yenescaliskan/DC_Motor_Drive/Simulation Report.docx

Middle East Technical University

Electrical & Electronics Engineering Department

EE463 – Static Power Conversion I

Hardware Project

Complete Simulation Report

Yasin Enes Çalışkan 2304319

Başak Koca 2232304

Mehmet Hakan Yel 2530699

# Introduction

For the motor drive system in the power electronics field, converters and rectifiers are essential. This project involves designing an AC/DC converter. The potential topologies discussed in this simulation report. The topology selection is made with respect to advantages and disadvantages of the design. The computation and simulations are provided for the chosen topology. There are both ideal and non-ideal instances in the simulations. The necessary components are selected utilizing the findings of studies following simulation and calculation analysis. Thermal analysis of the system is made.

# Problem Definition

Designing a controlled rectifier to drive a DC motor is a requirement for this project. The variable AC source is employed as the input. A kettle is wired to the DC motor and used to boil water.

Input and output constraints:

- Input: Three phase or single-phase AC
- Output: DC Output, Vdcmax <180 V

Motor specifications:

- Armature Winding: 0.8 Ω, 12.5 mH
- Shunt Winding: 210 Ω, 23 H
- Interpoles Winding: 0.27 Ω, 12 mH

# Possible Topologies for Solution

## 1) Single Phase Thyristor Rectifier

The Single-Phase Thyristor Rectifier design provides regulated operation. There are four thyristors in the topology. By altering the thyristors' firing angle, the rectifier's average output voltage can be changed. Therefore, with this architecture, we can convert AC to variable DC.

Applying a pulse signal to the thyristors' gate terminals regulates how they fire. The zero crossings of the input ac waveform should be recognized to synchronize the thyristors' firing timings. There must be a 180-degree phase difference between the firing angles. There is significant output voltage ripple. A capacitor with a high capacitance can be added to the system to decrease the high voltage ripple at the output.

There are two modes of single-phase thyristor rectifier. Average output voltage and current are positive when in rectification mode. Power flows through the rectifier in this mode from the input side to the output side. On the other hand, average output voltage turns negative while the output current remains positive in the inverter mode of operation. The power flows from output side to input side. Thus, the rectifier feeds power back into the grid. Average output voltage is seen in equation 1.

Vav=(2√2)/π Vph cosα (1)

Advantages

- Due to the fewer thyristors needed, it is affordable and small.
- By coupling two Single Phase Thyristor Rectifier circuits, it may be operated in four quadrants. If there is an active source on the rectifier's output side when it is in inverter mode, it can send power back to the grid. A positive current can flow while the output voltage remains positive.

Disadvantages

- The output has a high voltage ripple.
- It causes large harmonics in current. It can be reduced by adding inductor to the input, however that causes to increase in commutation time.
- It has low power factor.
- It is challenging to organize firing angles synchronously and extra circuits and sources are required to drive thyristors.
- A lower average output voltage than a three-phase thyristor rectifier.

Figure 1. Single Phase Thyristor Rectifier with RL Load

## 2) Three Phase Thyristor Rectifier

Figure 2. Three phase thyristor rectifier schematics.

Six thyristors are employed in the three phase thyristor rectifier. Thyristors are activated using gate signal generators to regulate output voltage. Theoretical output voltage calculation is as follows,

V_(avg) =(3√2 V_(ll))/πcosα=(3√6 V_(ph))/πcosα (2)

Advantages

- Without using an extra converter, the output voltage can be managed with a three phase thyristor rectifier.
- Output voltage ripple of this topology is lower than the single-phase thyristor rectifier topology.
- THD of this topology is lower. Since, the third harmonic of the input current is not observed.
- Back-to-back three phase thyristor rectifiers can be used to achieve four quadrant operation.

Disadvantages

- Thyristors are more expensive than regular diodes as component, and six thyristors make up this topology. This topology is therefore more expensive than other alternatives.
- Three phase thyristor rectifier topology requires the usage of six separate gate signals. In order to do this, gate drivers and additional components are needed. It raises the price and makes the structure more difficult.
- It is challenging to synchronize gate drivers. Since it should be taken into account, the zero-crossing issue.

## 3) Three Phase Diode Rectifier and Buck Converter

There are two sections of this topology. Three phase ac grid voltage is rectified in the first section to low ripple dc voltage. In the second section, we use a buck converter to adjust the output voltage using the switch's duty cycle.

Figure 3. Three phase diode rectifier schematic.

There is no control of average output voltage for three phase diode rectifier. Calculation of the output voltage is as follows,

V_(avg) =(3√2 V_(ll))/π=(3√6 V_(ph))/π (3)

In order to control the output voltage, a buck converter must be used after the rectifier circuit.

Figure 4. Buck converter schematic.

The input dc voltage is step-down to the desired level by the buck converter. A MOSFET that is driven by a gate signal is used to regulate output voltage. Output voltage of a buck converter simply calculated as,

V_(out) =V_(in) *D (4)

As we connect the rectifier and the buck converter, the output voltage becomes,

V_(avg) =(3√2 V_(ll))/π*D=(3√6 V_(ph))/π*D (5)

Advantages

- This topology has low voltage ripple in output.
- Only one gate signal is needed for this topology, and it will be supplied to operate the buck converter. In comparison to other topologies, this system is hence simpler. Additionally, syncing the signals is not needed in this topology.
- The cost of this system is lower than that of thyristor rectifiers.

Disadvantages

- Four quadrant operation is not supported by this topology. There is no method to obtain four quadrants because a diode rectifier can only operate in one quadrant.
- As a result of using an external diode in the buck converter, the predicted efficiency is lower than topologies with thyristors.

# Topology Selection and Reasoning

We gave information about 3 different alternative topologies that can be used within the scope of the project. We also listed the advantages and disadvantages of each topology. When we compared the advantages of each topology, we decided that three phase diode rectifiers with buck converter would be the most suitable topology for us.

The most effective factor in the selection of three phase diode rectifier topology with buck converter was simplicity. In other rectifier topologies using thyristor, it would be necessary to generate multiple gate signals and perform zero crossing detection to control the system. However, in a topology with a diode rectifier, only the gate signal will be needed for the buck converter that we will add to the system. In addition, its cheapness and low output voltage were also effective in our decision.

# Simulations of Selected Topology

In this part, the simulation of the topology we have chosen are made part by part.

## a) Three Phase Diode Rectifier Simulation

Within the scope of the project, we were asked to drive the motor with a maximum of 180V DC. Therefore, the output voltage that we will see at the output of our entire system at the maximum duty cycle value that we will determine for the buck converter should be 180Vrms DC. When we consider the output that the buck converter will provide, we know that the output voltage of buck converters varies in direct proportion according to the duty cycle percentage of the switch used in the converter. However, since high duty cycle values cannot be achieved in practice, we have determined the maximum duty cycle value of the gate signal that we will use for the switching process as 80%. For us to see 180Vrms in the buck converter output with 80% duty cycle, our input phase voltage should be calculated as follows,

V_(out) =(3√6 V_(ph))/π*D where V_(out) =180V and D=0.8 (6)

V_(ph) =96.2V_(rms)

Since the ideal case will be considered in our simulation, the value of 96.2Vrms is used as the input pahse voltage. However, due to the voltage drop due to commutation and other nonidealities, the amount of input voltage will need to increase a little more.

The circuit schematic used for the simulation of the three-phase diode rectifier is as in figure 5.

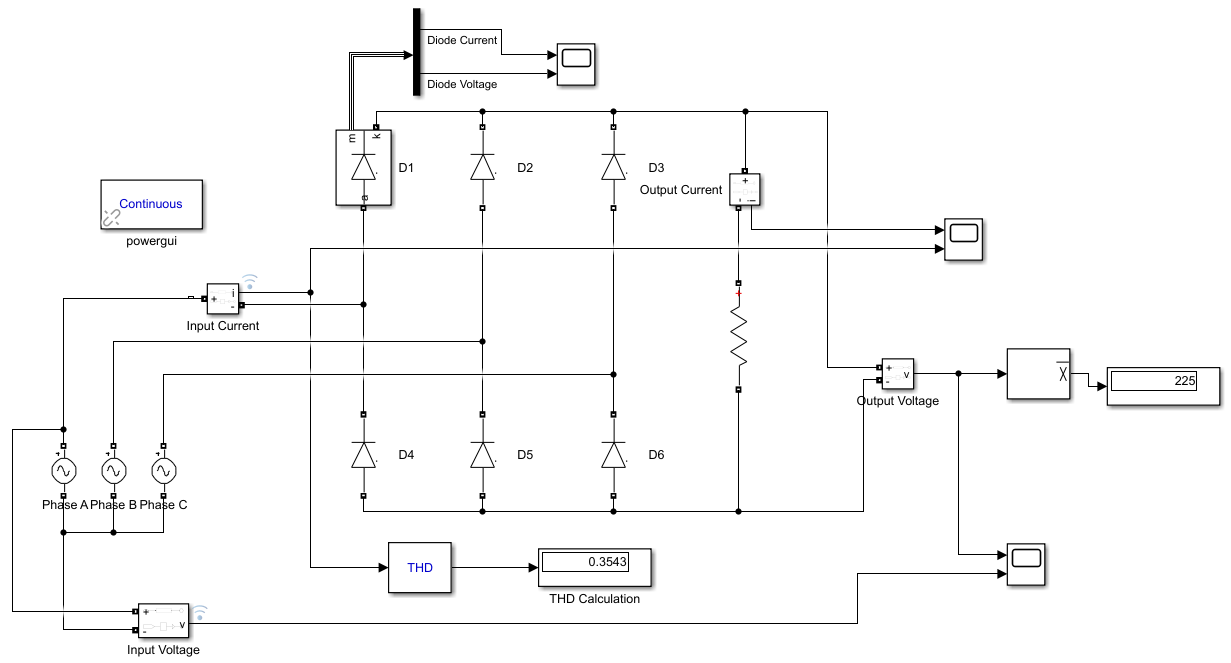
[picture p2: figure]

Figure 5. Circuit schematic for simulation of three phase diode rectifier.

Simulation results of input and output voltage waveform are included in figure 6.

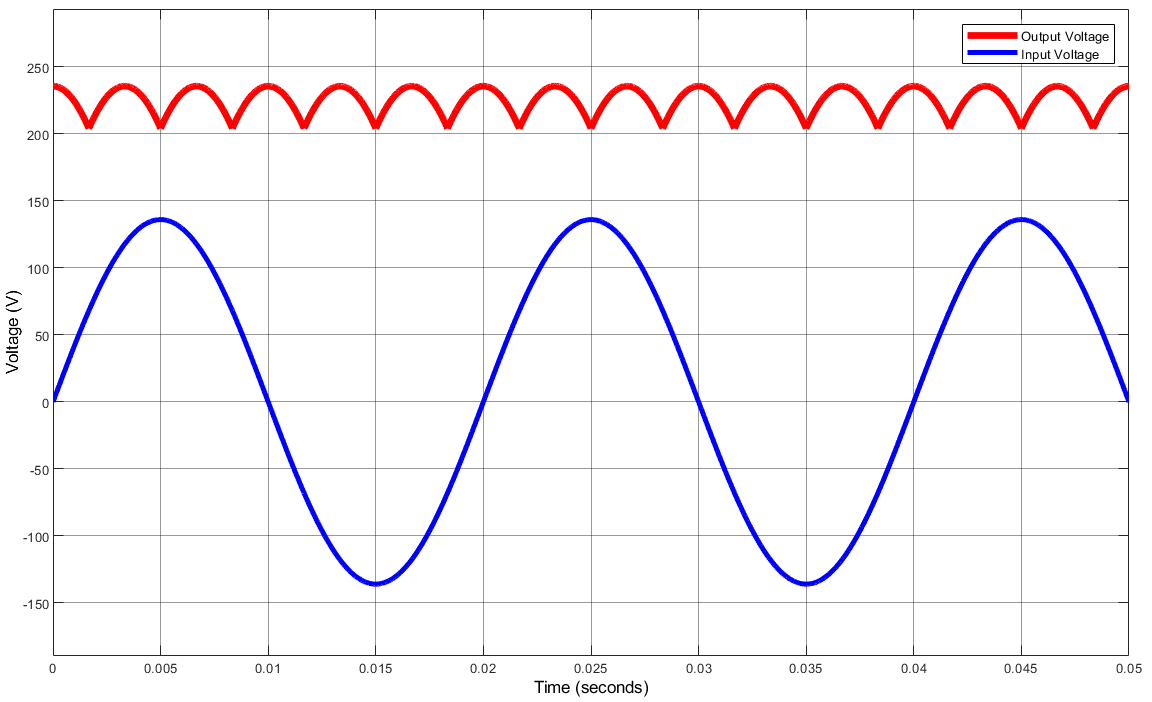
[picture p3: figure]

Figure 6. Input and output voltage waveforms of three phase diode rectifier.

The simulation results of the input and output current waveform are given in figure 7.

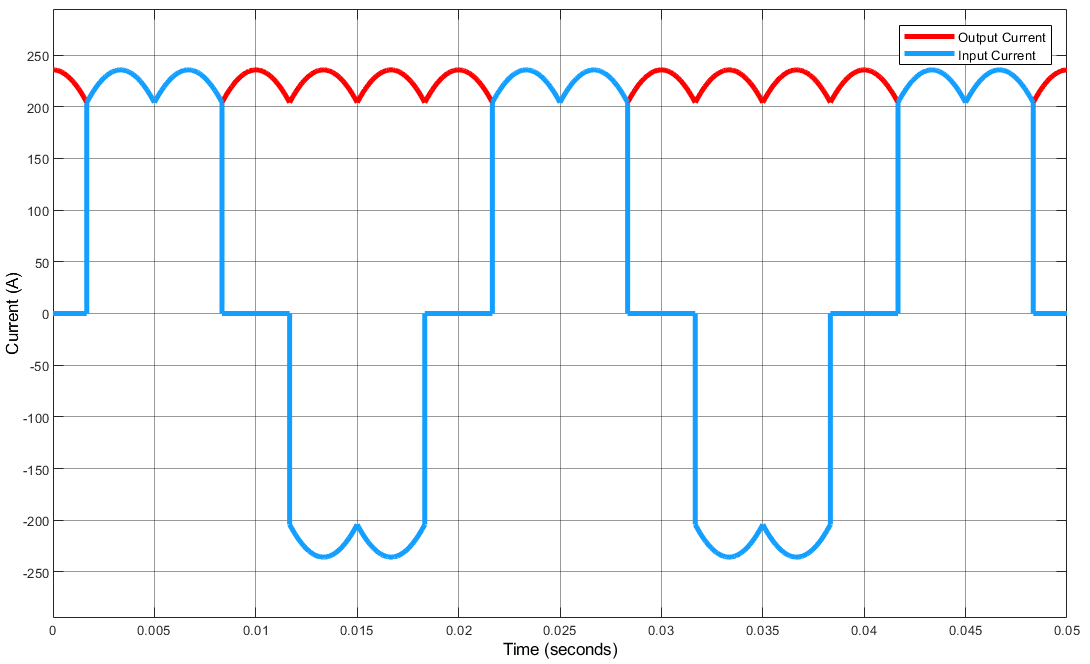
[picture p4: figure]

Figure 7. Input and output current waveforms of three phase diode rectifier.

The waveform showing the voltage and current flowing through one of the diodes used in the rectifier is as in figure 8.

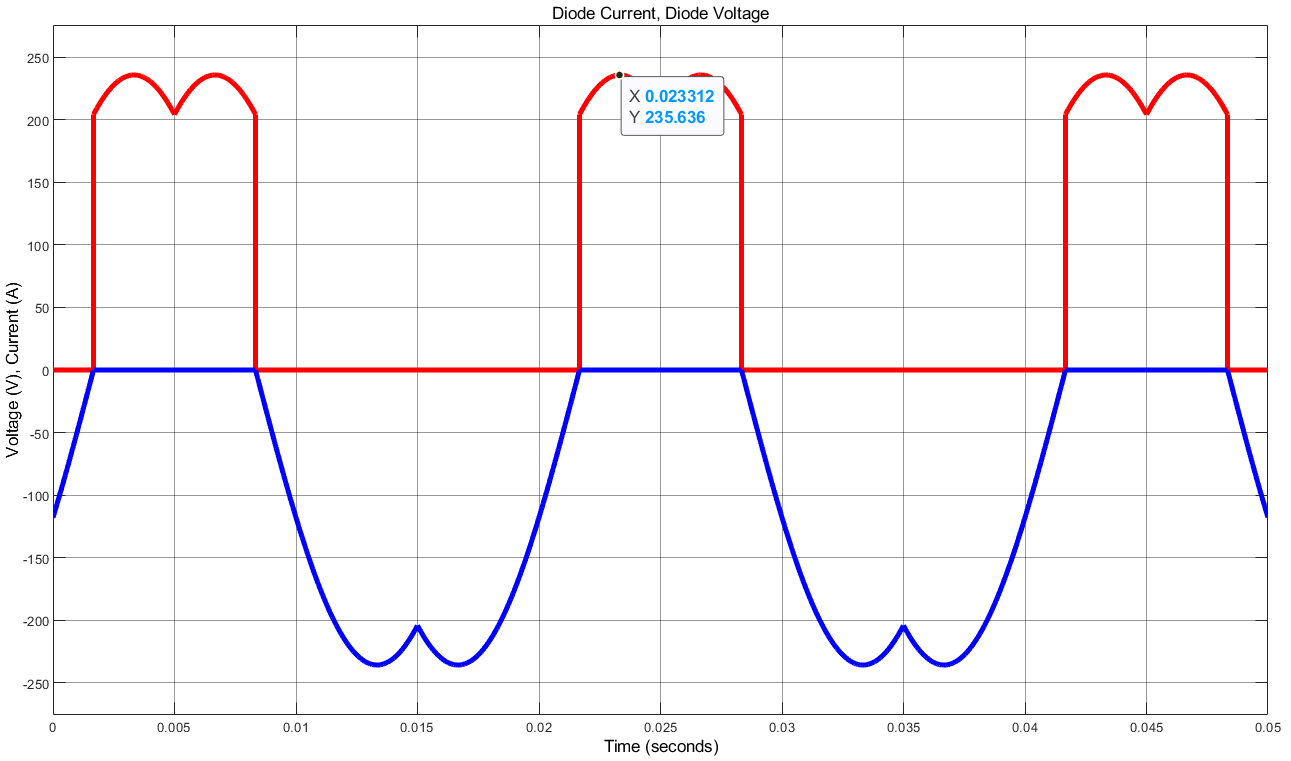
[picture p5: figure]

Figure 8. Diode current and voltage waveforms for three phase diode rectifier.

Only 1ohm resistor was used as load in the simulation model. Since no capacitor is used as a load, the observed ripple voltage is higher than a capacitor rectifier. When we examined the simulation plots obtained, it was observed that the waveforms were according to the ideal case without line inductance and resistances as expected.

Since the resistance value used in the load is 1ohm and our diode is considered ideal, the maximum voltage value on the resistor and the maximum current that will pass through it are equal and 235.6V and 235.6A. The maximum current rating varies according to the resistance at the load.

## b) Buck Converter Simulation

Figure 2 shows the Simulink simulation schematic for the Buck Converter design. To view the output voltage and current, diode voltage and current and MOSFET voltage and current waveforms, the circuit is simulated on Simulink with duty cycle 10%.

The gate signal of a MOSFET or IGBT is selected using the controller, which is discussed later. The duty cycle is set at 0.1 at startup and subsequently climbs to 0.8. At first, the motor had no back emf because we applied 0.05 V to the load side, which is series to RL load. The DC motor itself is a RL load and an additional LC filter isn’t needed for the Buck Converter.

The motor parameters used to calculate R and L of the load. Resistance of the load is defined as 1.065 ohm and inductance of the load is 24 mH. MOSFET or IGBT has a switching frequency of 1 kHz.

To have a 180 V DC, 80% duty cycle is used for the gate signal of MOSFET. Output voltage formula for the basic buck converter can be seen from the equation above.

Vout = Vin× Duty Cycle%=225× 80/100=180 V (7)

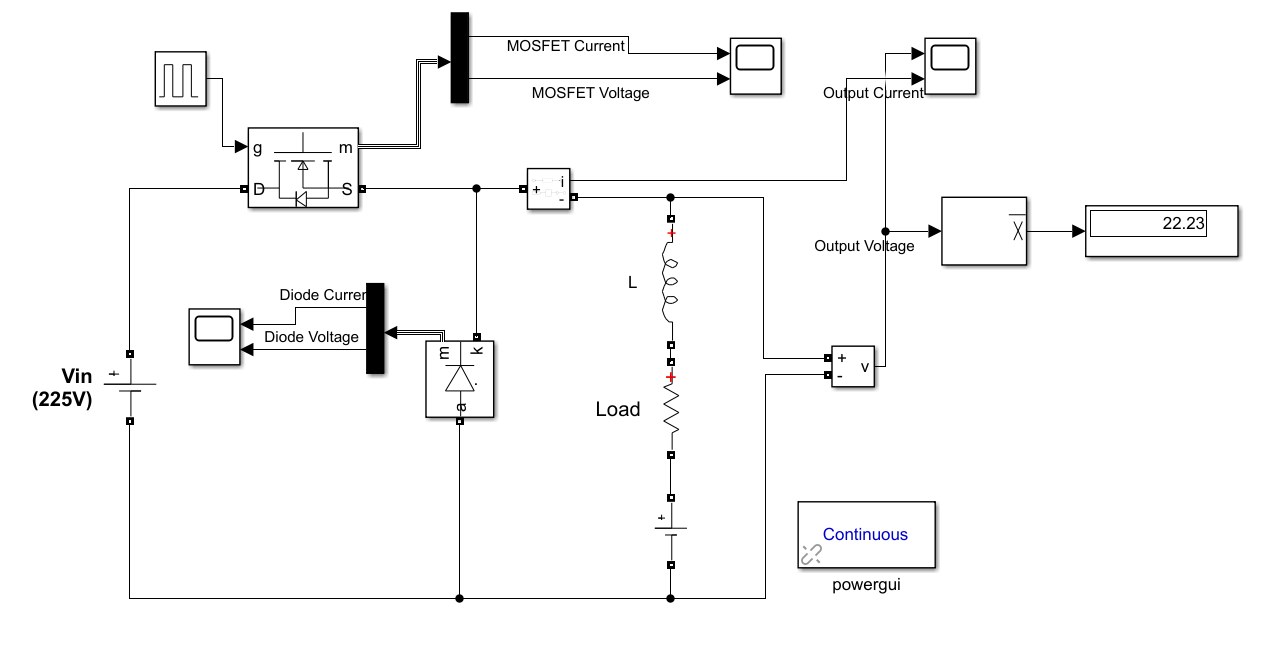
[picture p6: figure]

Figure 9. Schematic of Buck Converter

Figure 10 displays the output voltage and output current waveforms at duty cycle 10%. The ripple in the output voltage is measured to be close to 225 V.

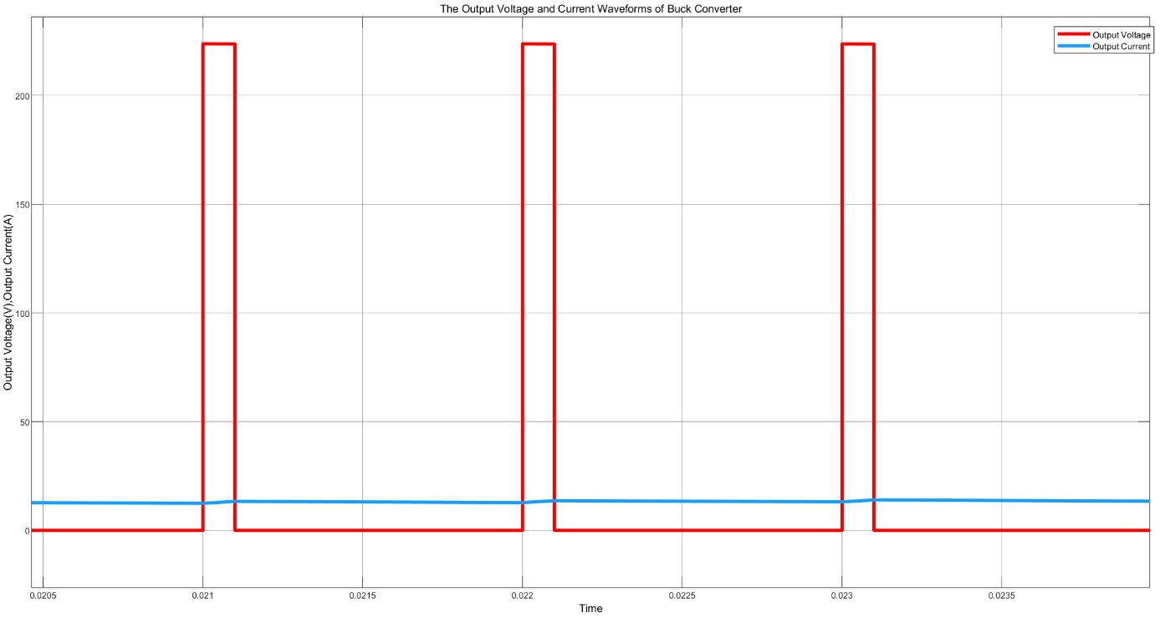
[picture p7: figure]

Figure 10. Buck Converter Output Voltage and Output Current Waveforms

MOSFET voltage and current waveforms are seen in Figure 11. Approximately 225 Volts is the MOSFET's maximum limiting voltage, and its maximum current is 15 Amps.

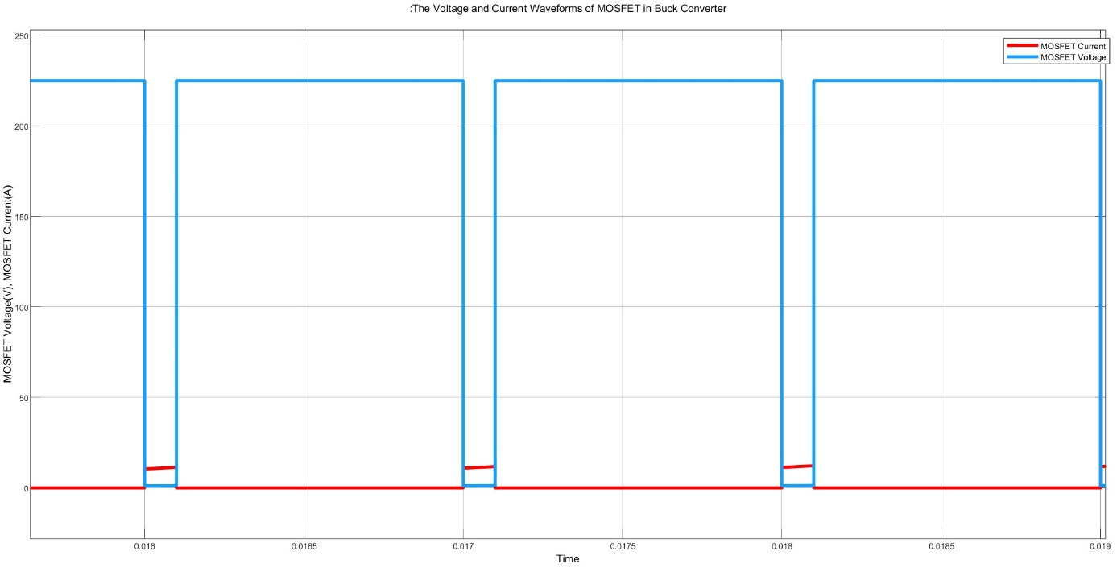
[picture p8: figure]

Figure 11. The Voltage and Current Waveforms of MOSFET of Buck Converter

The Figure 12 shows the voltage and current waveforms across the diode of the Buck Converter. The limiting voltage at the free-wheeling diode is about 224 V and the maximum forward current value is roughly 13 A.

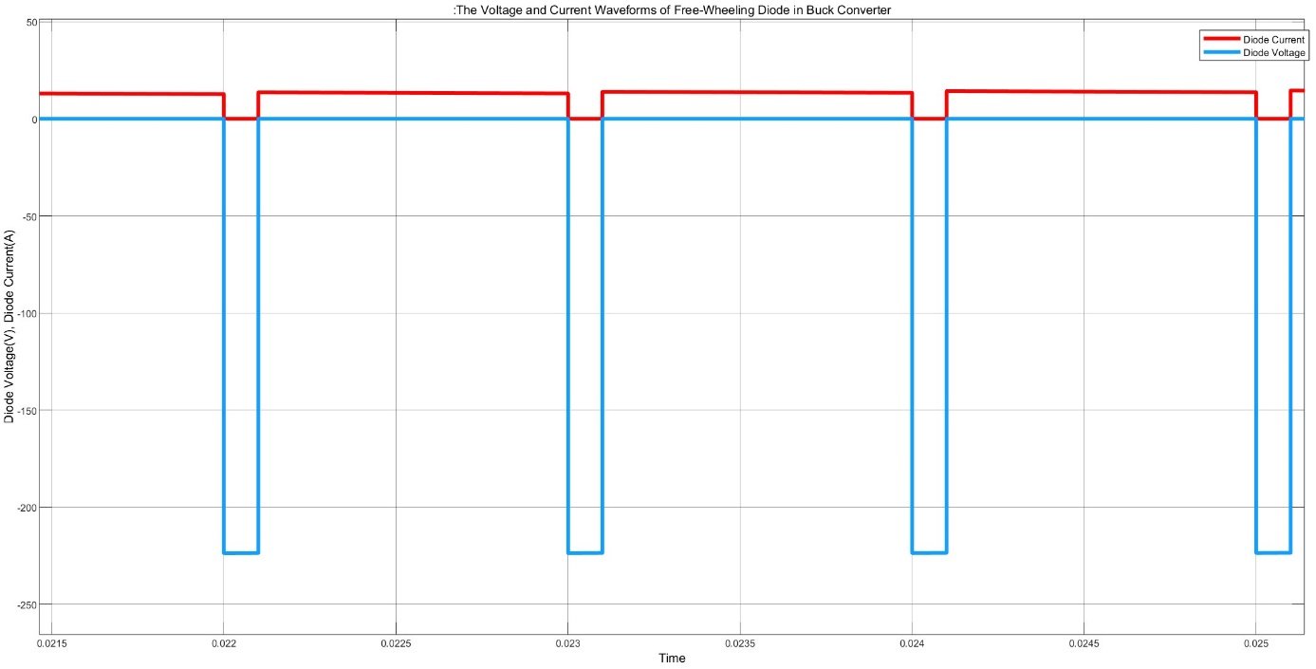
[picture p9: figure]

Figure 12. The Voltage and Current Waveforms of the Diode of Buck Converter

## c) Three Phase Diode Rectifier and Buck Converter Simulation

The schematics of power circuitry along with the DC motor is shown in Fig. 13. Although the DC motor is supposed to be separately excited, it is modeled as permanent magnet motor as its field excitation is never to be varied. Its back emf constant is set to 220V/1500rpm, total inertia is set to 1kg/m², armature resistance and inductance are set to 0.8 ohms and 12.5 mH respectively. The friction torques are neglected.

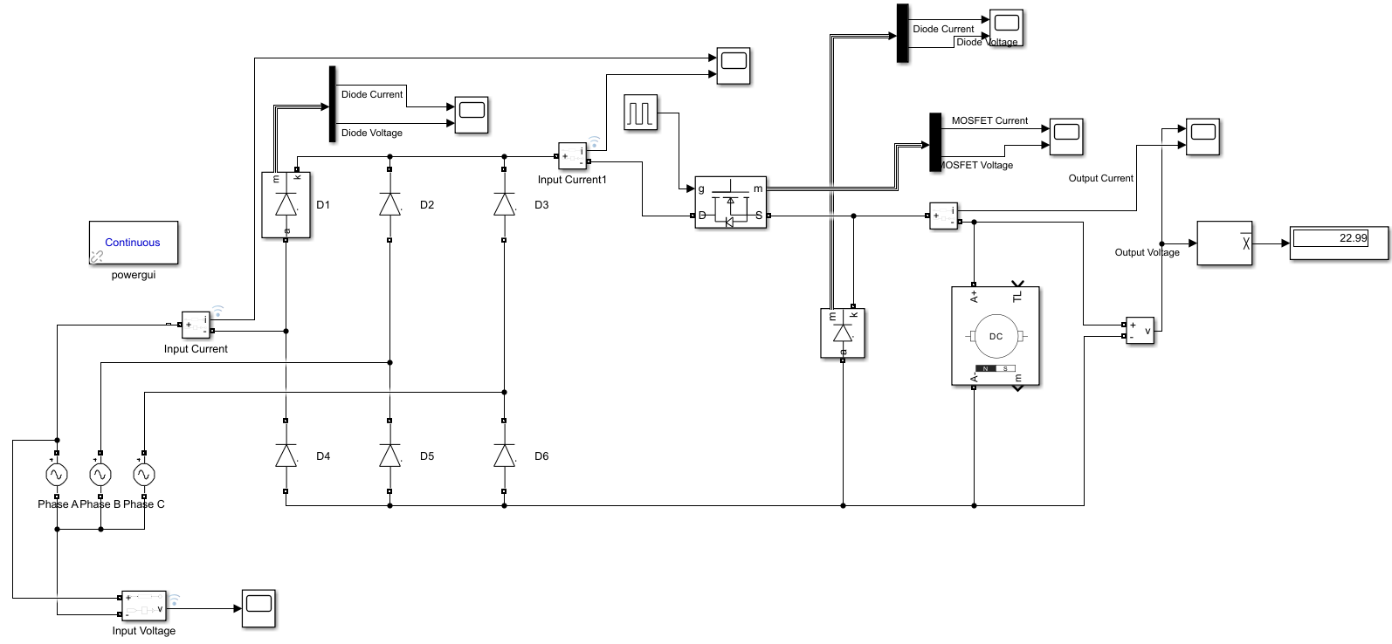
[picture p10: figure]

Figure 13. Schematics of Combined Circuit Connected to the DC Machine

Fig. 14 shows the voltage, current and speed of the motor with 10% duty cycle at steady state. As seen, it operates around 10% of its rated speed and the steady state current is very small with average of 0.2A under no load as frictions are neglected. With 10% duty cycle, average output voltage is 10% of rectified voltage.

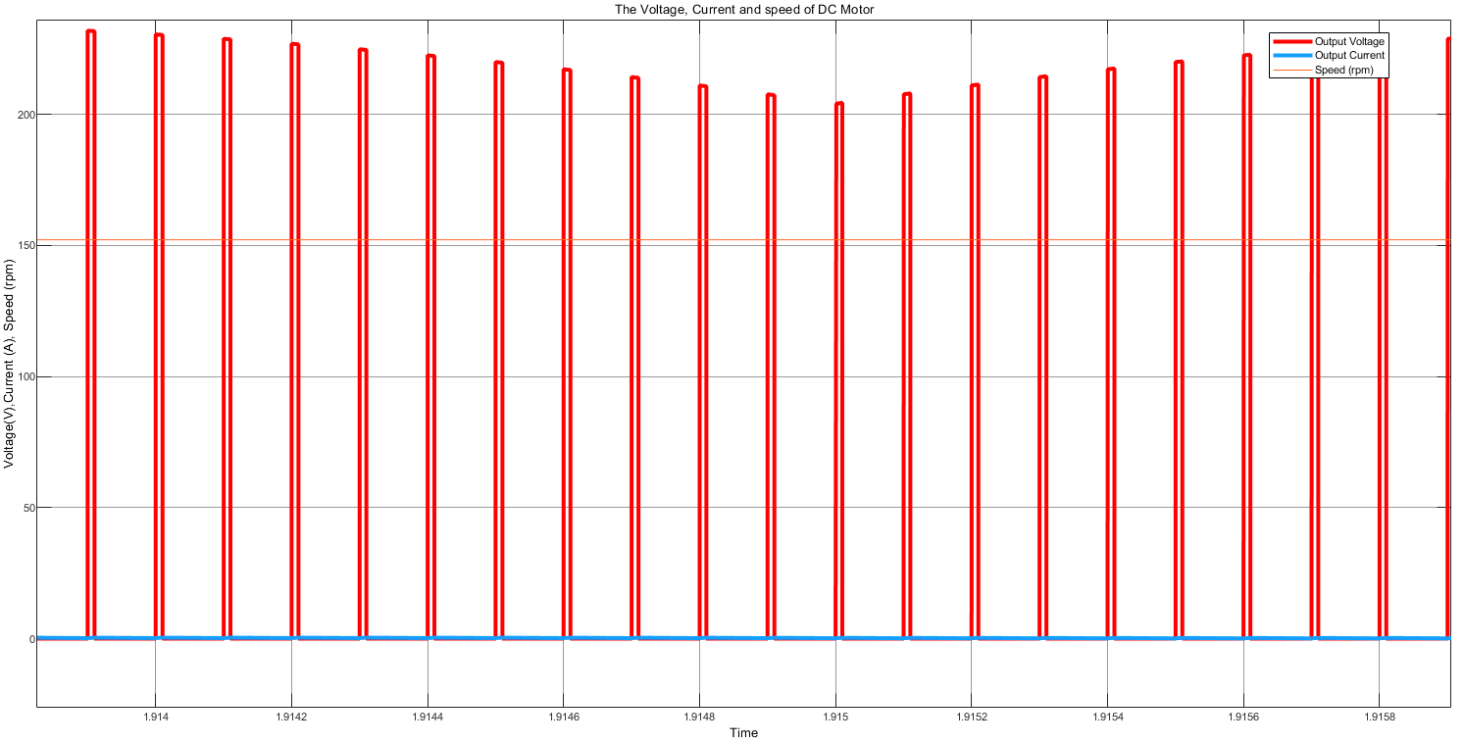
[picture p11: figure]

Figure 14. The Armature Voltage, Current and Speed of the Motor in Steady State (D=10%)

However, even with duty cycle of 10%, the motor responds with an inrush current with peak value of 25A before speeding up and reaching its steady state as seen in Figure 15.

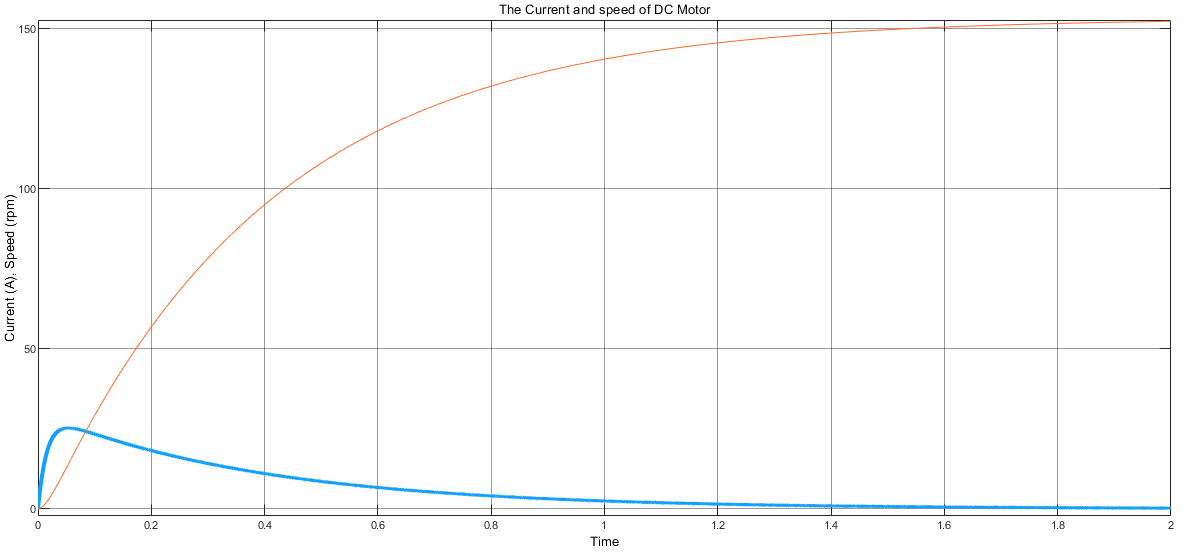
[picture p12: figure]

Figure 15. Transient Current and Speed of the Motor (D=10%)

The peak value of rectifier diode current is 25A and voltage is 235V as seen in Figure 16.

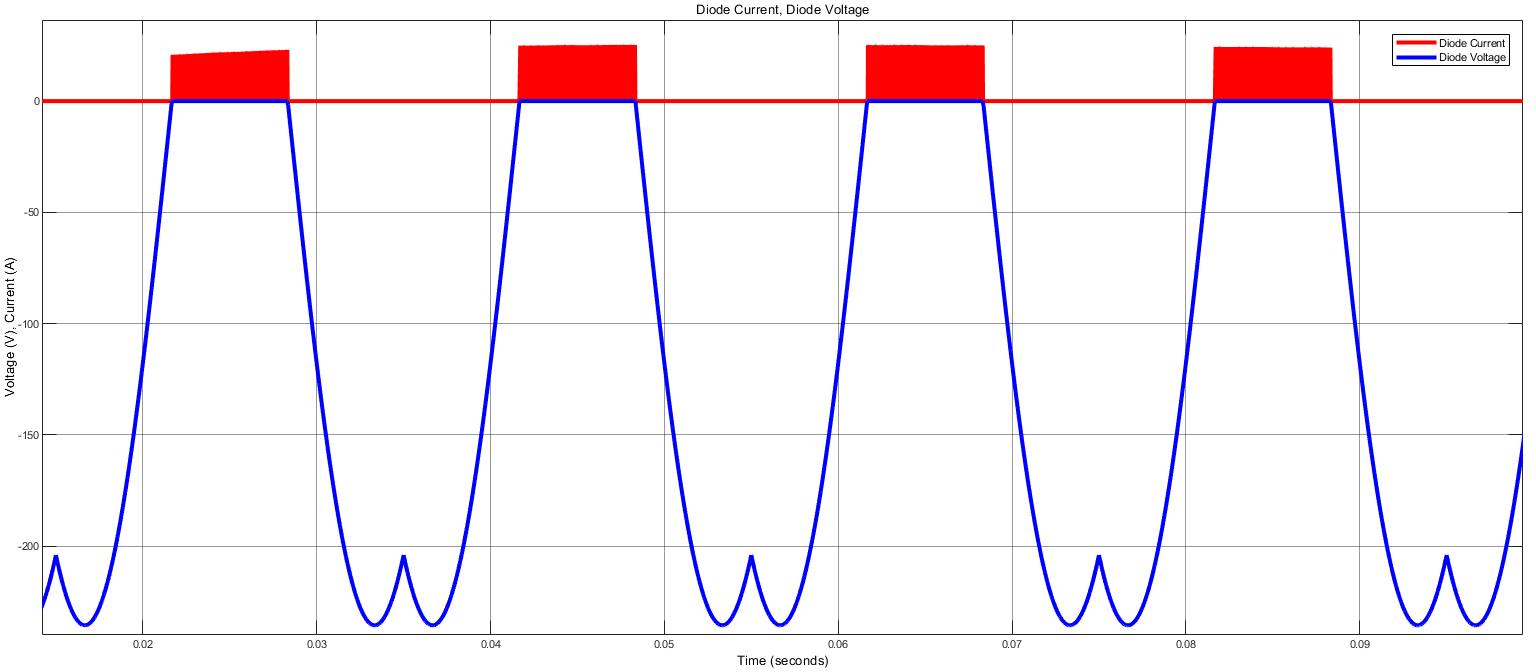
[picture p13: figure]

Figure 16. Rectifier Diode Voltage and Current Waveforms (D=10%)

Similarly, the peak value of freewheeling diode current is 25A and voltage is 235V as seen in Figure 17.

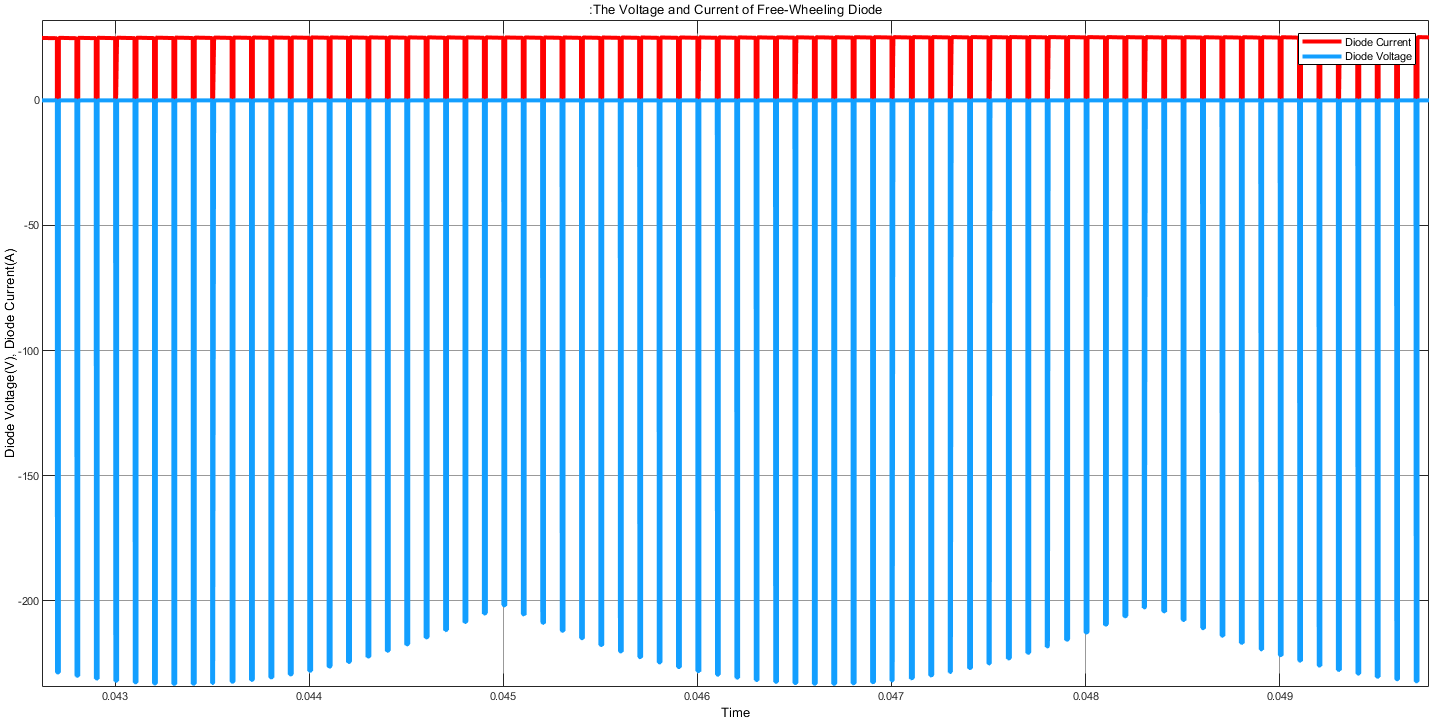
[picture p14: figure]

Figure 17. Freewheeling Diode Voltage and Current Waveforms (D=10%)

Even during start-up, MOSFET Current is not high as the duty cycle is very low. Its drain to source voltage has peak of 235V and the current does not exceed 2.5A any instant as seen in Figure 18.

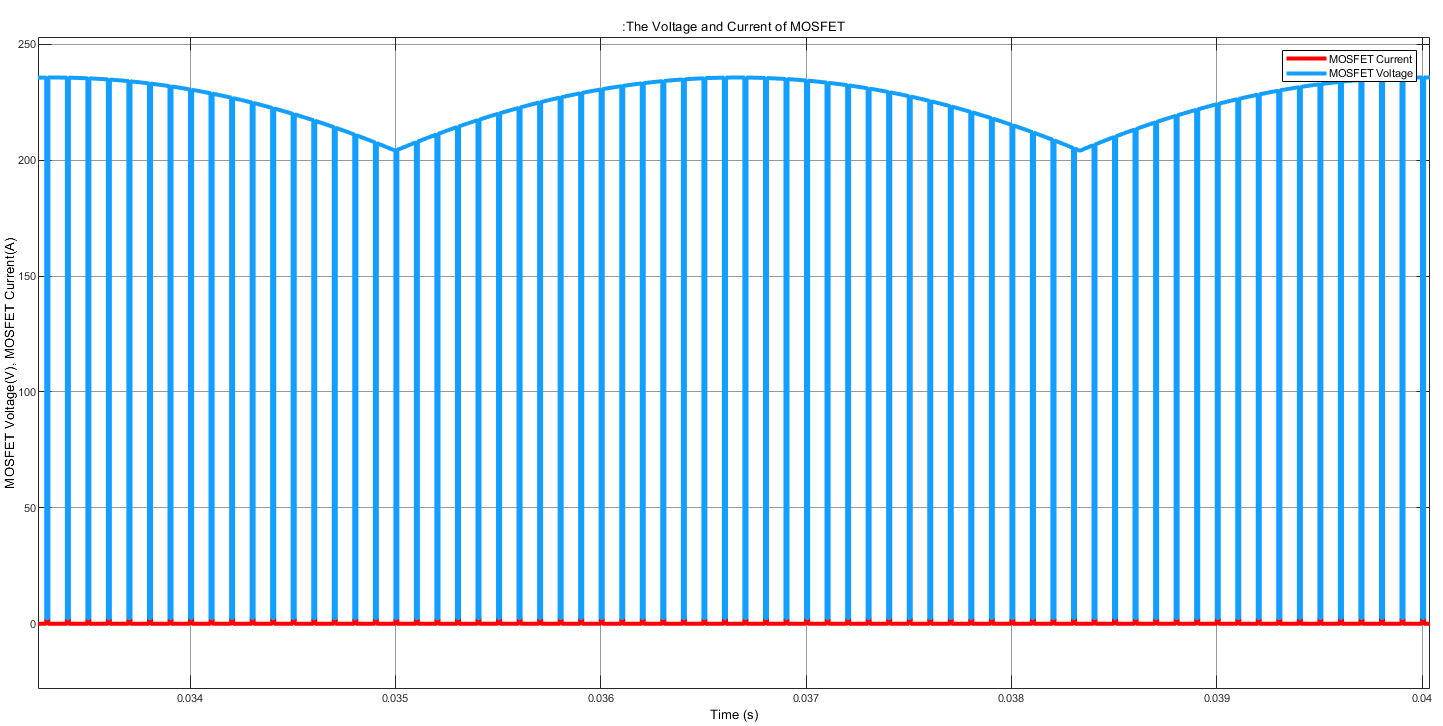
[picture p15: figure]

Figure 18. MOSFET Voltage and Current Waveforms (D=10%)

After starting the motor up with 10% duty cycle, it needs to be supplied with higher voltage with higher duty cycle to reach its rated speed of 1200rpm.

To observe the motor’s behavior at its rated speed, one needs to take the frictions into account. It is known that the motor has around 250W losses due to friction. This leads to a constant friction torque of 1.59Nm.

The motor voltage, current and speed at steady state with 80% duty cycle is shown in Figure 19. As seen, the average voltage is 180V, RMS current is 1A. and speed is 1222rpm.

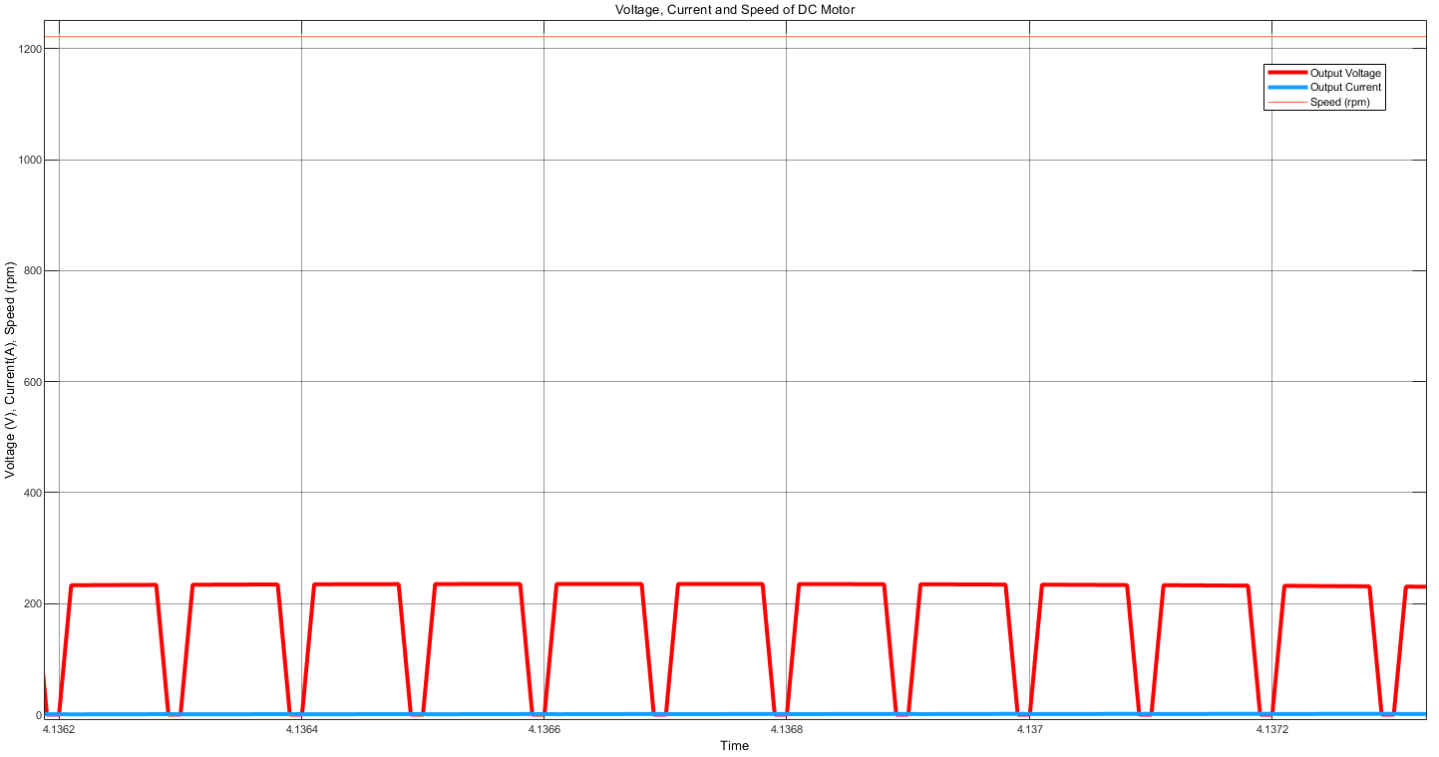
[picture p16: figure]
tablo içeren bir resim Açıklama otomatik olarak oluşturuldu

Figure 19. The Armature Voltage, Current and Speed of the Motor in Steady State (D=80%)

With 80% duty cycle at steady state, voltage of rectifier diode is the same 235V but its current does not exceed 2A as it does not have inrush current.

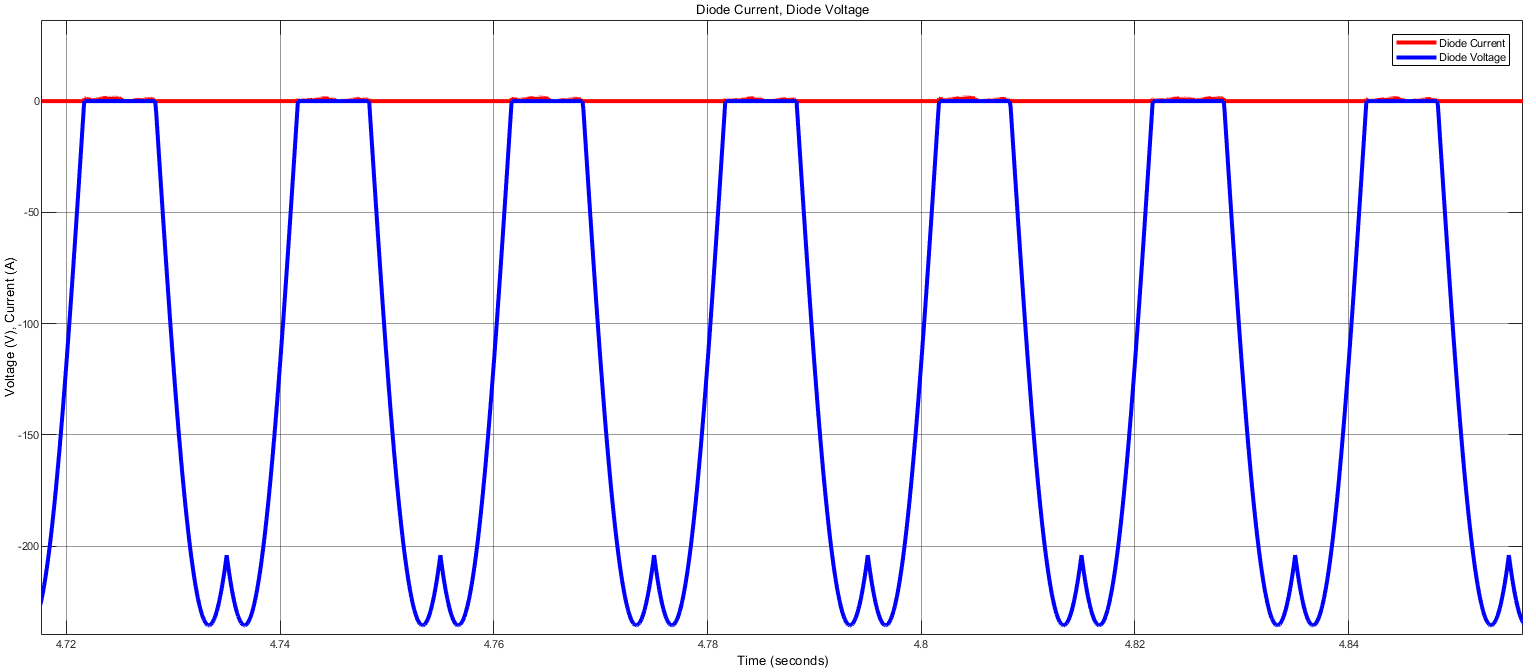
[picture p17: figure]
metin, iç mekan içeren bir resim Açıklama otomatik olarak oluşturuldu

Figure 20. Rectifier Diode Voltage and Current Waveforms (D=80%)

Similarly, freewheeling diode peak voltage is 235V and current is 0.8A RMS as seen in Figure 21.

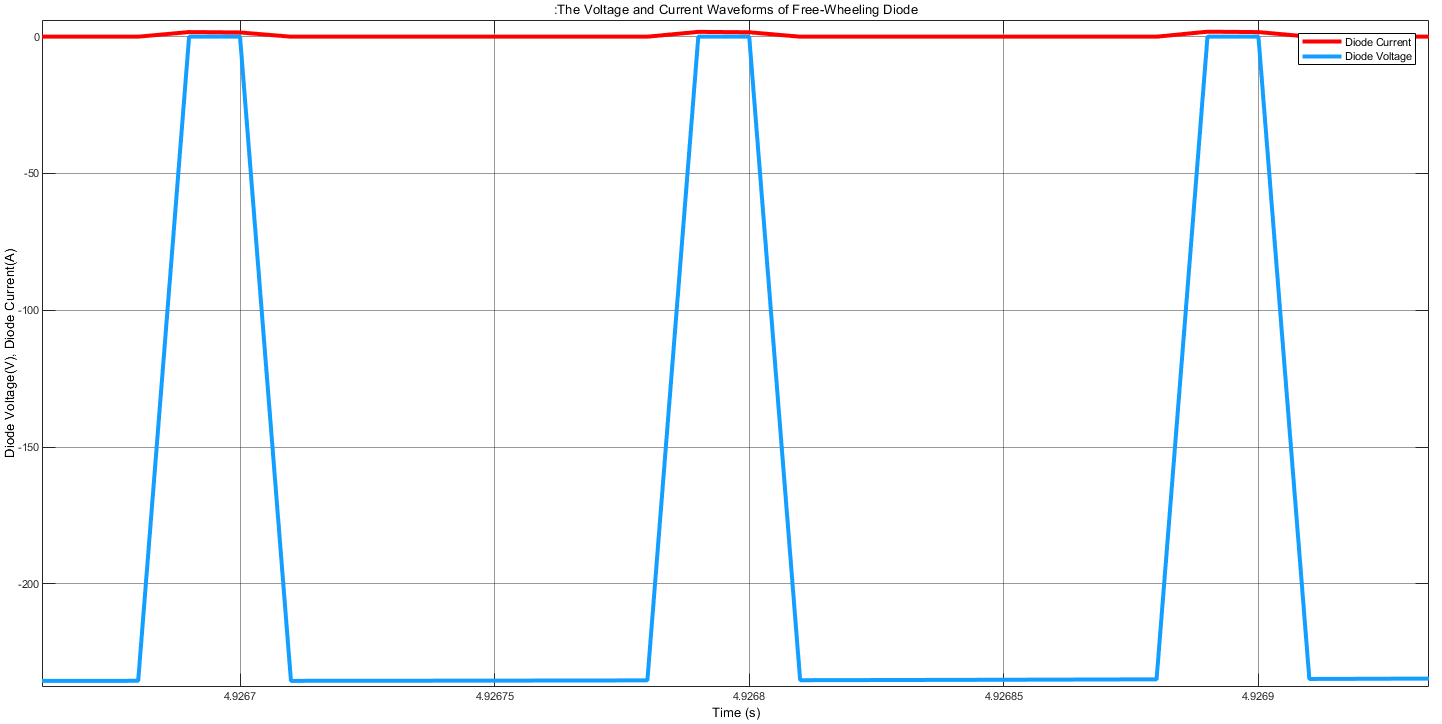
[picture p18: figure]

Figure 21. Freewheeling Diode Voltage and Current Waveforms (D=80%)

In steady state with no load and 80% duty cycle, MOSFET current does not exceed 1.5A and its voltage has still peak of 235V as seen in Figure 22.

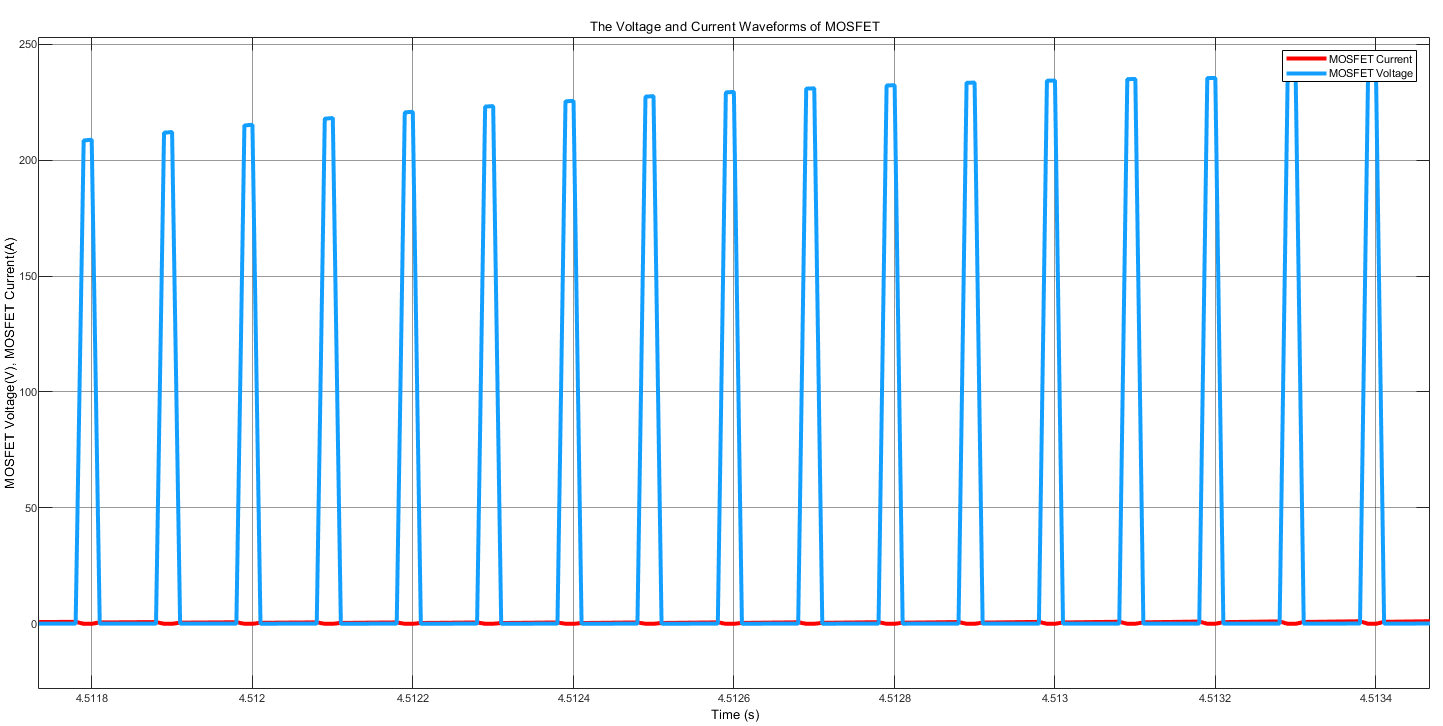
[picture p19: figure]

Figure 22.MOSFET Voltage and Current Waveforms (D=80%)

# Simulation of Controller

Our choice for the controller IC to operate the IGBT is the LM555. This IC can generate PWM signals with consistent frequency.

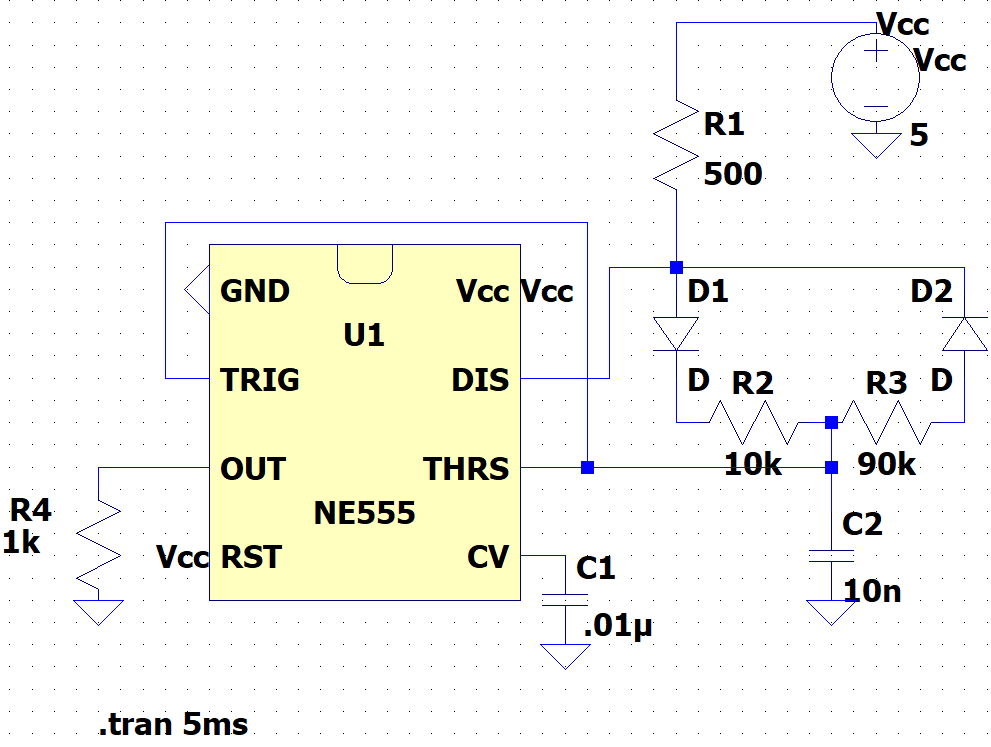
[picture p20: figure]
tablo içeren bir resim Açıklama otomatik olarak oluşturuldu

Figure 23. 555 Timer circuit schematic in LTspice.

R2 and R3 in the figure x stand in for a potentiometer. For operating at a constant frequency, two diodes are required. The IC will receive 5V as an input. The potentiometer and capacitor attached to the Threshold pin (C2) control the frequency of the PWM signal at the Output pin. Additionally, duty cycle can be adjusted by varying the ratios of R2 and R3, where D≈R2/(R3+R2) (R1 is very small). [1]

High frequency causes components like diodes or IGBTs to lose more energy, increasing heatsink area as a result. Considering substantial energy losses, it is decided to adopt a frequency of 1 kHz. Since the frequency formula in this arrangement is f≈1/[(R2+R3)*C2, a potentiometer value of 100k and a capacitor of 10nF are chosen, theoretically producing 1kHz. However, various factors can impact this frequency, making it difficult to achieve 1 kHz precisely. Fortunately, this does not affect our circuit negatively because the simulation yielded almost the same frequency. Figures 24 and 25 show the output voltages for two different duty cycles, D=0.1 and D=0.8. Theoretical and simulated duty cycles are extremely similar.

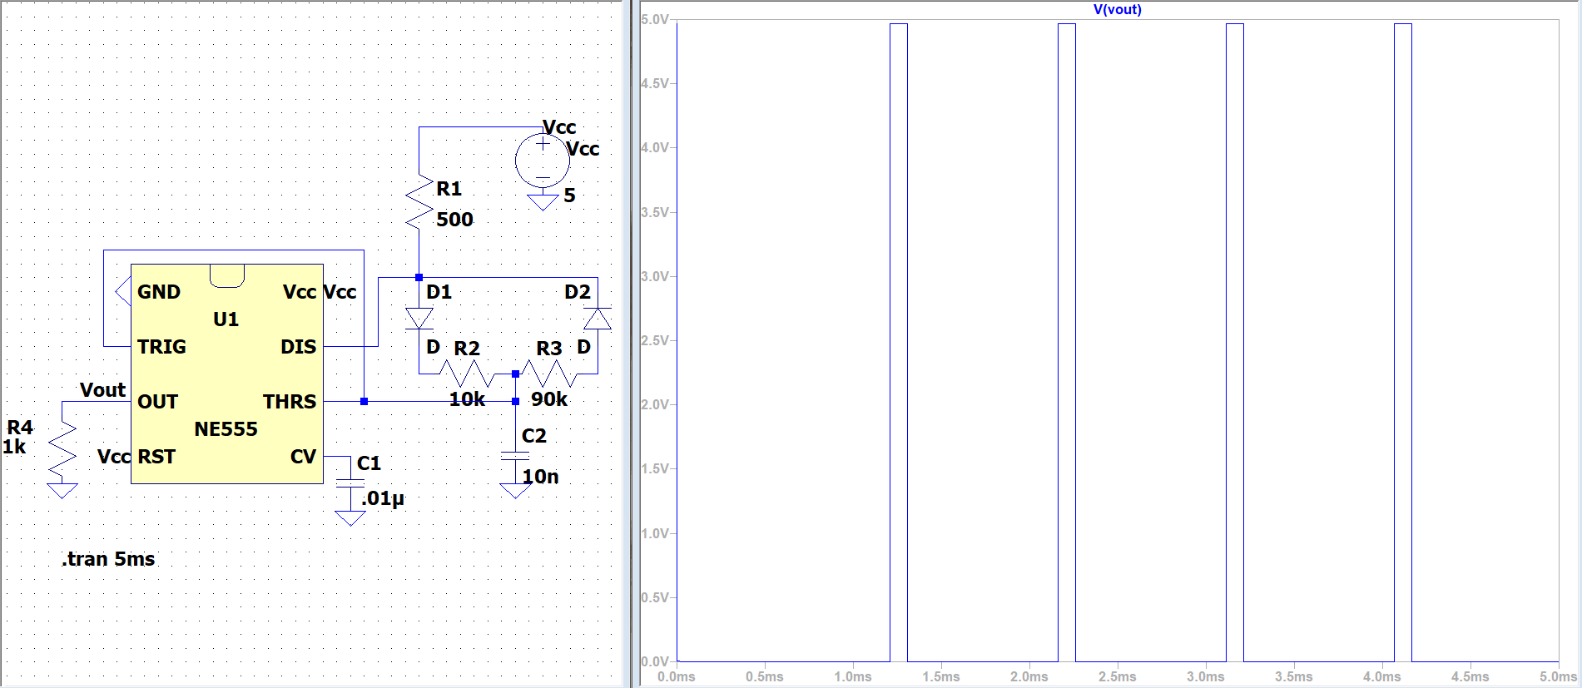
[picture p21: figure]

Figure 24. Output of the 555 Timer circuit for 10% duty cycle.

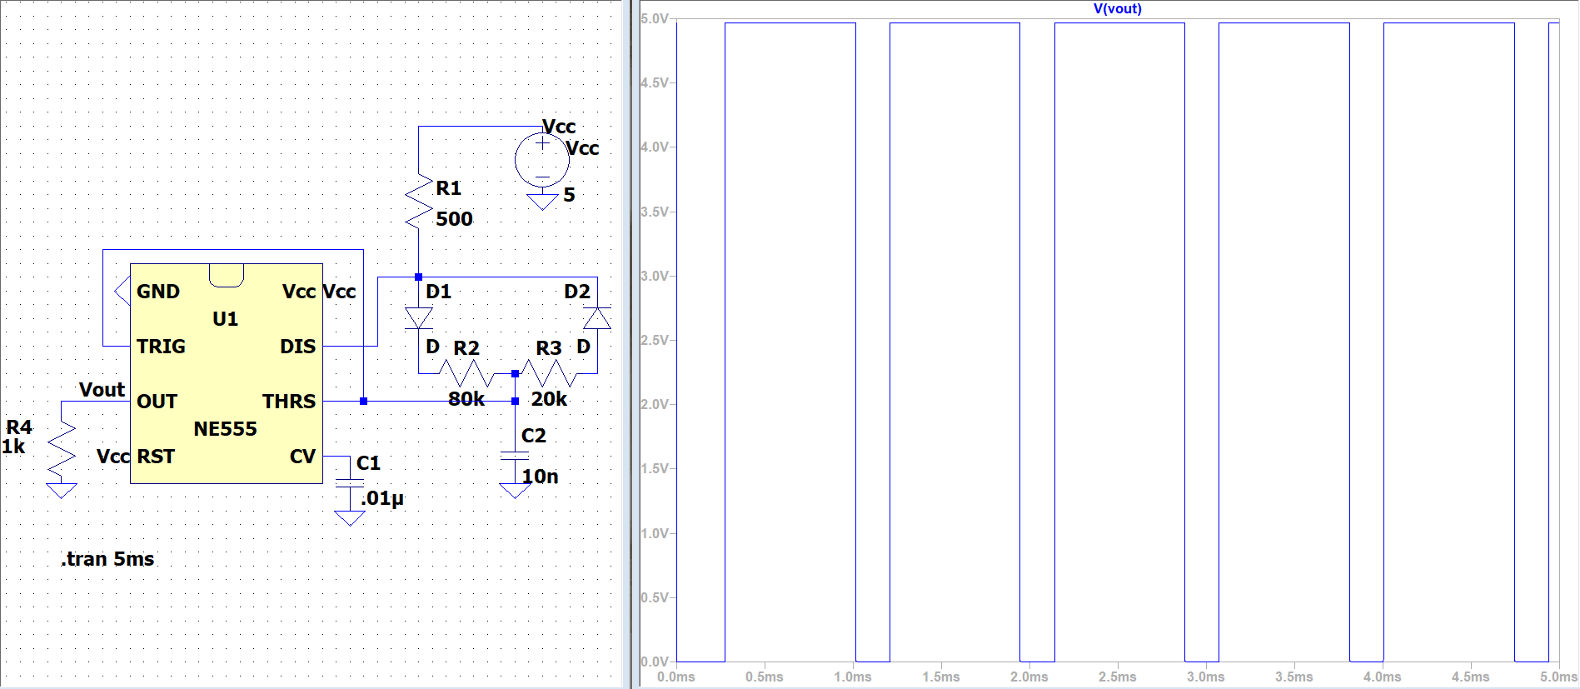
[picture p22: figure]

Figure 25. Output of the 555 Timer circuit for 80% duty cycle.

# Component Selection

IXGH24N60C4D1 N IGBT

We made the decision to use a MOSFET that can handle up to 15-20 A average current. According to the findings of the simulation, the MOSFET's voltage rating must be more than 235V. IXGH24N60C4D1 N Channel IGBT is available and a good choice for the design.

GUO40-12NO1 Bridge Diode

To maximize compactness and provide simplicity, we have decided to utilize one bridge diode as rectifying diodes on the input side rather than six individual diodes. Rectifier diodes should have a minimum operating voltage of 235 and 25A. 40 A and 1200 V are the limiting voltage and current values of GUO40-12NO1.

DSEP30-06B

Reverse blocking voltage of free-wheeling diode is observed as 235 V and forward current observed as 25 A. DSEP30-06B has chosen as it carries the current until 30 A and has a reverse voltage limit of 600 V.

100 µF 400 V Capacitor

To reduce the voltage ripple, we decided to place a capacitor after the rectifier component. After factoring in a safety margin, we came to the decision to utilize a 100F 400V capacitor to work properly close to 250V.

# Thermal Analysis

IGBT

Conduction and switching losses should be calculated for IGBT. Parameters for the selected IGBT is given in the datasheet provided [2].

Pconduction = Von×Ion×D (8)

Pswitcℎing = (Eon + Eoff) × f (9)

For Tj =25℃, turn-on energy is given 0.40 mJ and turn-off enegy is given 0.30 mJ. For Tj =125℃, turn-on energy is given 1.00 mJ and turn-off enegy is given 1.10 mJ. The switching frequency is 1kHz.

Pswitcℎing = (0.69 + 0.77) × 1k = 1.46 W at 25℃ (10)

Pswitching = (1.00 + 1.10) × 1k = 2.10 W at 125℃ (11)

Ion has an average of 1.1A for MOSFET in the simulations. VCE(sat) is equal to 1.5 at Tj = 25℃ and 1.9 V at Tj = 175℃. Pconduction can be found as follows:

Pconduction = 1.5 × 1.1 × 0.8 = 1.32 W at 25 ℃ (12)

Pconduction = 1.9 × 1.1 × 0.8 = 1.67 W at 175 ℃ (13)

Total IGBT losses also can be found as follows:

PIGBT(total) = Pconduction + Pswitcℎing = 1.46 W + 1.32 W = 2.78 W at Tj = 25℃ (14)

Bridge Diode

At room temperature 25°C, The forward voltage drop at forward current of 30A is 1.28V, which makes conduction loss of 38.4W. This voltage drop and loss decreases with increasing junction temperature and it is not going to draw that much current all the time but for worst case scenario, we assume that it is going to operate with this heat dissipation. In which case without heatsink or fan, the junction temperature will be 1945 °C from equation 15 as thermal resistance junction to ambient is 50 K/W. Therefore, we need to have a heatsink to protect the device from overtemperature during inrush current. If we assume that case temperature is constant with 25°C, then junction temperature will be 175°C which is the upper border of normal condition. Considering that increasing temperature decreases the heat dissipation and this inrush current duration is very small compared to heating time constant, a heatsink without a fan would be sufficient.

T_j =T_(amb) +P/(R_(j,amb)) (15)

Free Wheeling Diode

The following formula can be used to determine the losses for the free-wheeling diode at the end of the buck converter:

P_(conduction) =V_F I_F D (16)

P_(switching) =V_(reverse) ×f_(sw) ×t_(rr) ×I_(rr) ×1/2 (17)

The datasheet of the chosen diode contains the necessary information for the calculations (4). In our situation, V_(reverse) , which is depicted in simulations as 235 Volts, is the maximum voltage on the free-wheeling diode.

P_(switching) =235 V×1kHz×25ns×2.5A×1/2=7.344 mW at T_(VJ) =25℃,I_F =30 A (18)

P_(switching) =235 V×1kHz×70ns×4.5A×1/2=37.013 mW at T_(VJ) =100℃,I_F =30 A (19)

In our situation, the free-wheeling diode can withstand a maximum current flow of roughly 25 Amps. the datasheet states:

At T_(VJ) =25℃ :

V_F =2.51 V at I_F =30 A

V_F =3.19 V at I_F =60 A

At T_(VJ) =150℃ :

V_F =161 V at I_F =30 A

V_F =2.24 V at I_F =60 A

The following formula can be used to compute a free-wheeling diode's conduction loss:

P_(conduction) =V_F I_F D=2.51×25×0.8=50.2 Watt at T_(VJ) =25℃ (20)

P_(conduction) =V_F I_F D=1.61×25×0.8=32.2 Watt at T_(VJ) =150℃ (21)

# Conclusion

Our objective in this project is to design an AC/DC converter. We defined the case and investigated several topologies. By analyzing advantages and disadvantages of the circuit topologies we decided to construct Three Phase Diode Rectifier with Buck Converter.

Detailed simulations of the three-phase diode rectifier, buck converter and the three-phase diode rectifier with buck converter were made with addition of control input to MOSFET. Controller simulation was also made, and 555 Timer PWM Generator was used.

According to the voltage and current simulation results, the components to work with were decided. Thermal analysis of the components was made.

In conclusion, the study confirms the effectiveness of the decided technique at the theoretical and simulation levels.

# References

[1] Engineers Garage. "IC555 PWM output" YouTube, Jul . 26, 2013 [Video file]. Available: https://www.youtube.com/watch?v=8hiQR8a2q4Y&t=61s. [Accessed: Dec. 10, 2022].

[2] IXYS . “Low Loss IGBT : IGBT in TRENCHSTOP™ and Fieldstop technology”, IGW30N60T, 2015.

[3] Littelfuse. “Standard Rectifier”, GUO40-12NO1, 2019.

[4] IXYS . “HiPerFRED”, DSEP30-06B, 2021.
