yenescaliskan/DC_Motor_Drive/Simulation Models/Controller.asc

C1: cap; .01µ
C2: cap; 10n
D1: diode
D2: diode
R1: res; 500
R2: res; 80k
R3: res; 20k
R4: res; 1k
U1: NE555
Vcc: voltage; 5
Named nets: 0, Vcc, Vout
.tran 5ms
