yenescaliskan/DC_Motor_Drive/Simulation Models/dimmer/dimmer.asc

C1: cap; 100n
L1: ind; 12.5m
POT: res; 5k
R3: res; 0.8
U1: SCR; EC103M3
U2: DIAC; DB3
V1: voltage; SINE(0 400 50)
V2: voltage; 180
Named nets: 0
.tran 0 0.5 0 uic
.inc C:\\Users\\user\\Documents\\LTspiceXVII\\lib\\st_diacs.lib
.inc C:\\Users\\user\\Documents\\LTspiceXVII\\lib\\st_high-temperature_scr.lib
.inc C:\\Users\\user\\Documents\\LTspiceXVII\\lib\\Thyristor_SCR_EC103xx_SxSx_A_SPICE_Model_lib.lib
1k-350k
