yenescaliskan/DC_Motor_Drive/(commit log)

2022-12-10 Added PWM Controller LTSpice Model
2022-12-10 Buck converter simulation
    duty cycle of pulse generator is %10, will be increased to 80 gradually in reality
2022-12-10 Smiulation report was updated. (simulation of buck converter part was added)
2022-12-10 Controller circuit schematic was updated and controller simulation was completed.
2022-12-10 Added combined circuit model
2022-12-10 Added Rectifier and Buck Converter Part to Report and Numbered Figures
2022-12-10 Başak'ın yaptıgı edit
    1. topology advantages /disadvantages added, buck converter simulation modified and comment added. component choice added. conclusion added
2022-12-10 Thermal analysis of selected diodes were added to the report.
